vp080808/HP9915-Keyboard/HP9915_KbdLayout.png

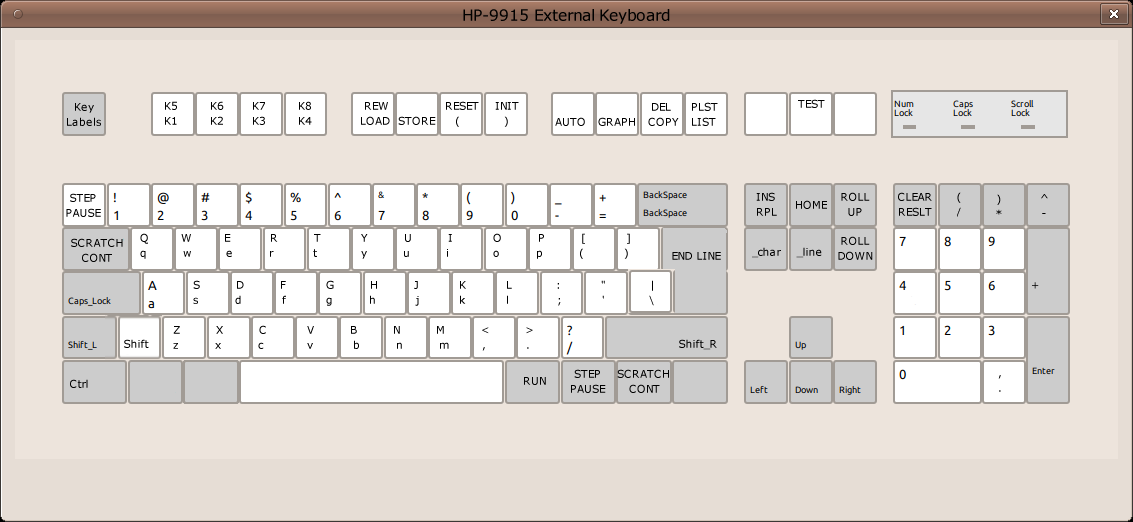
HP9915_KbdLayout.png
