vp080808/HP9915-Keyboard/9915KbdIDC-2.pdf

## ZARLINK

MT093

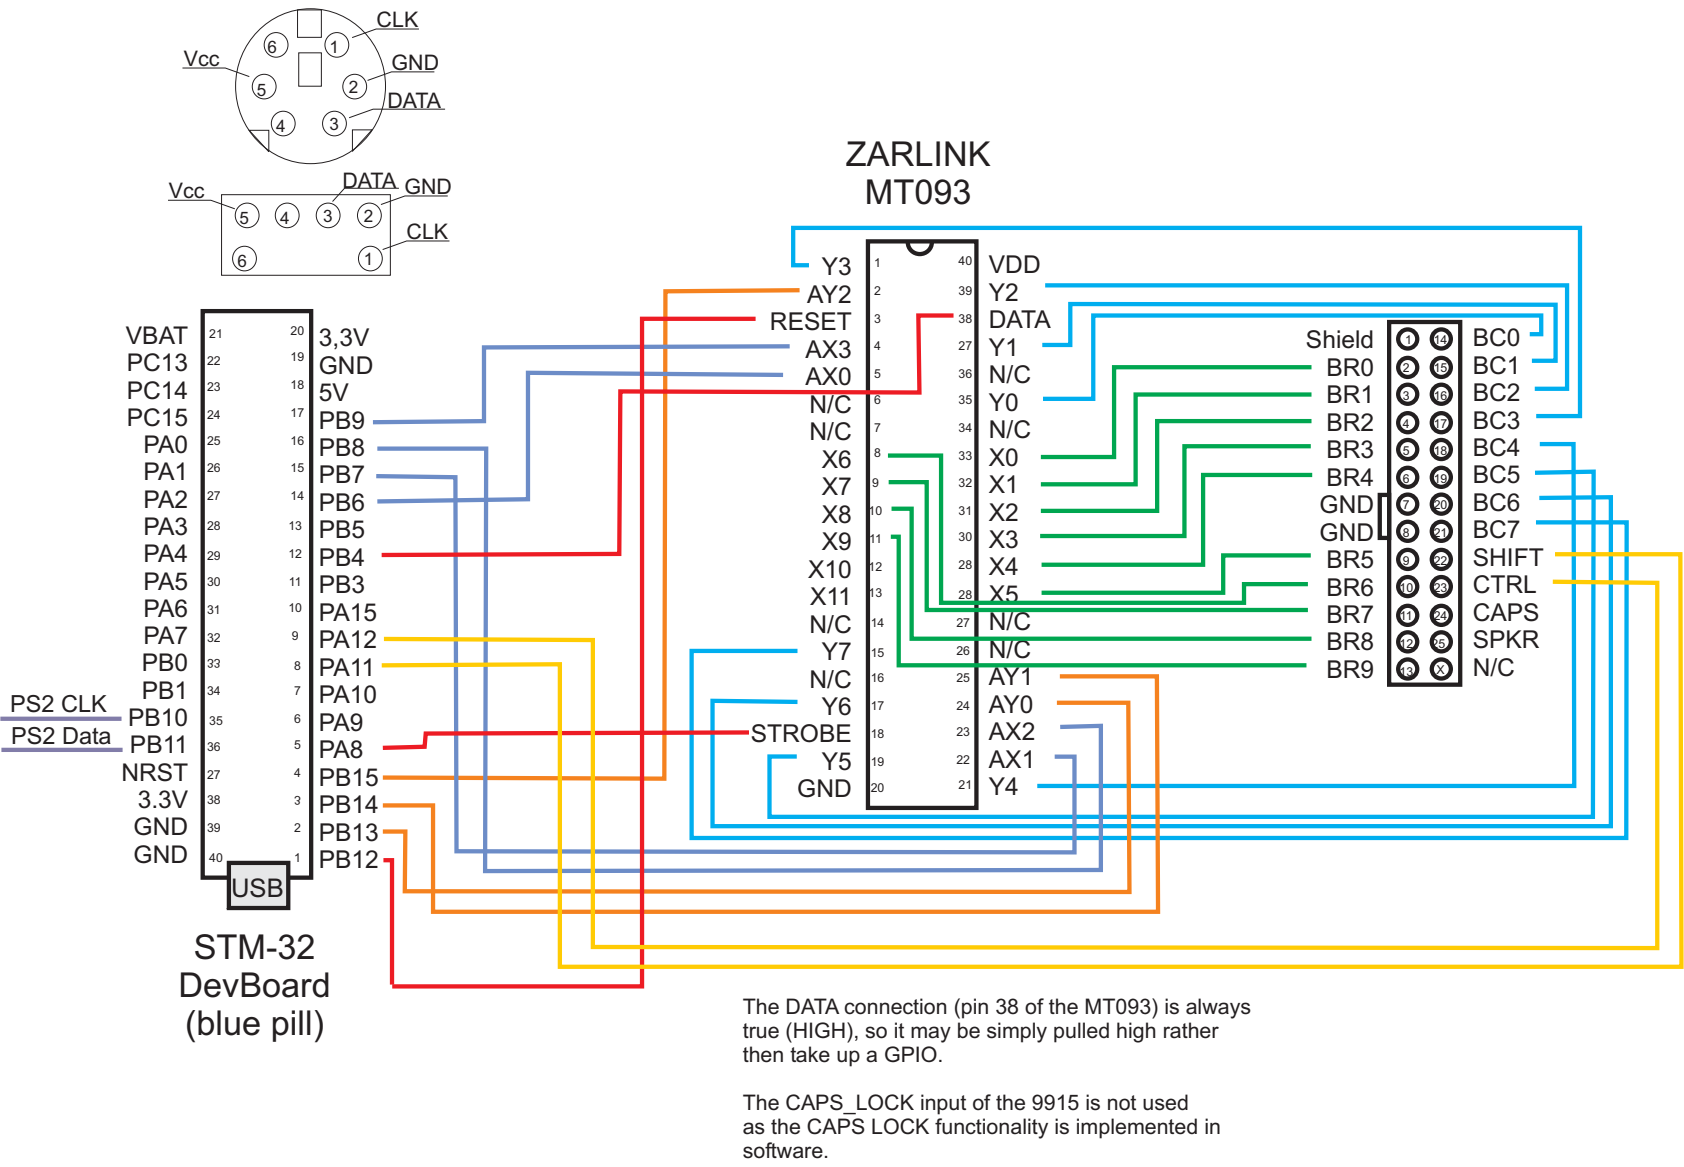
[picture p2: page 1]
Shield BR0 BR1 BR2 BR3 BR4 GND GND BR5 BR6 BR7 BR8 BR9; BC0 BC1 BC2 BC3 BC4 BC5 BC6 BC7 SHIFT CTRL CAPS SPKR N/C; Y3 AY2 RESET AX3 AX0 N/C N/C X6 X7 X8 X9 X10 X11 N/C Y7 N/C Y6 STROBE Y5 GND; VDD Y2 DATA Y1 N/C Y0 N/C X0 X1 X2 X3 X4 X5 N/C N/C AY1 AY0 AX2 AX1 Y4; USB; 3,3V GND 5V PB9 PB8 PB7 PB6 PB5 PB4 PB3 PA15 PA12 PA11 PA10 PA9 PA8 PB15 PB14 PB13 PB12; VBAT PC13 PC14 PC15 PA0 PA1 PA2 PA3 PA4 PA5 PA6 PA7 PB0 PB1 PB10 PB11 NRST 3.3V GND GND; CLK; GND; DATA; Vcc; PS2 CLK PS2 Data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

then take up a GPIO.

The CAPS_LOCK input of the 9915 is not used
as the CAPS LOCK functionality is implemented in
software.
